poko56/ESP32_Clock/5_top_section.png

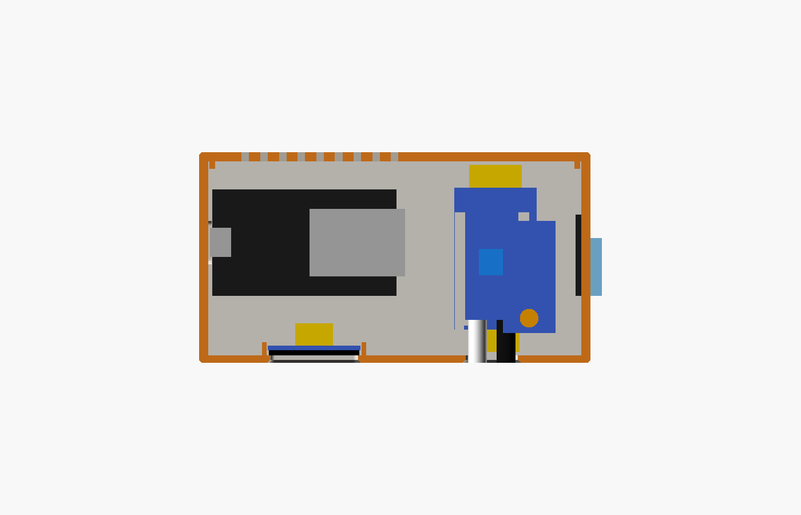
5_top_section.png
