poko56/ESP32_Clock/6_left_usb.png

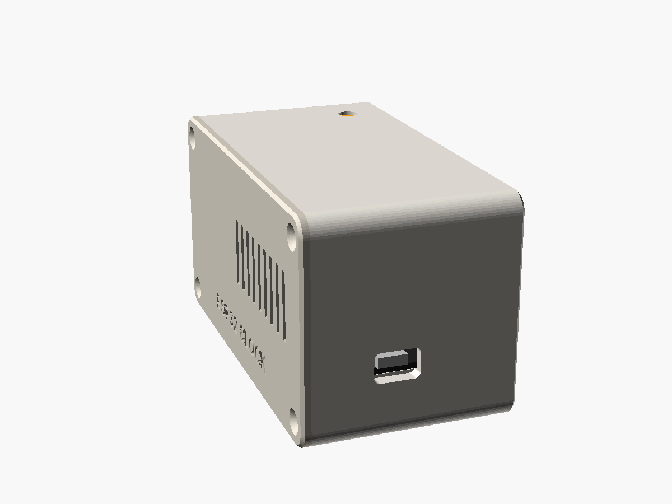
6_left_usb.png
