poko56/ESP32_Clock/body_print.stl

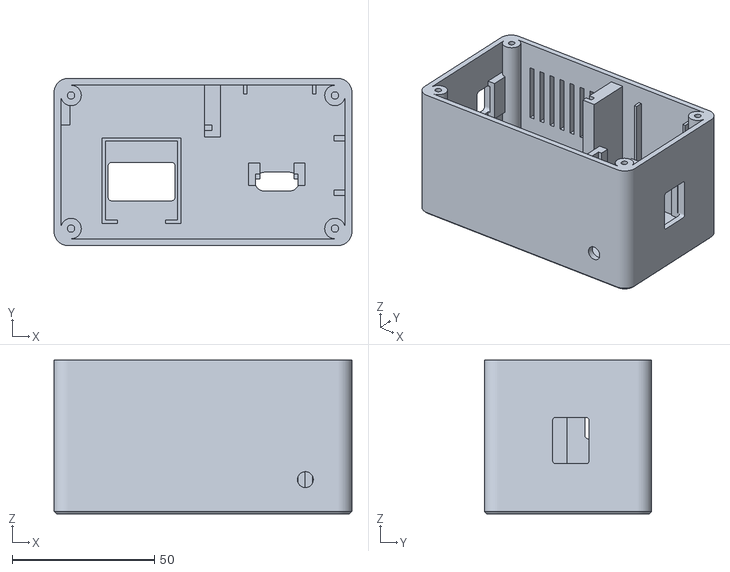
[picture p4: CAD file, 2026-11-08]
body_print.stl
104.8 x 58.8 x 54.0
