poko56/ESP32_Clock/cover_print.stl

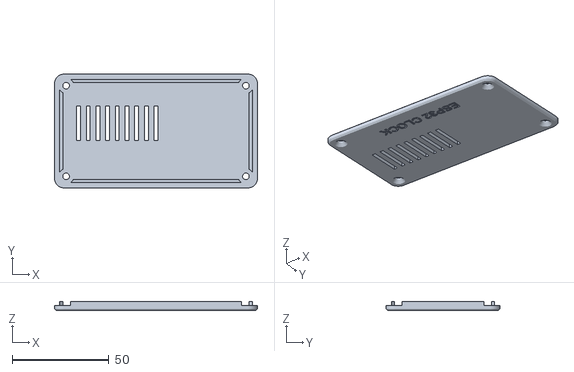
[picture p5: CAD file, 2026-11-08]
cover_print.stl
104.8 x 58.8 x 4.50
